jottinger/alcyone/README.md

alcyone
=======

Alcyone is my midi foot controller project.
