jottinger/alcyone/(list of files, drawings)

Other design files:
schematic.fzz
