jottinger/alcyone/wiringPiStub/wiringPi.c

/*
 * wiringPi:
 *	Arduino compatable (ish) Wiring library for the Raspberry Pi
 *	Copyright (c) 2012 Gordon Henderson
 *	Additional code for pwmSetClock by Chris Hall <chris@kchall.plus.com>
 *
 *	Thanks to code samples from Gert Jan van Loo and the
 *	BCM2835 ARM Peripherals manual, however it's missing
 *	the clock section /grr/mutter/
 ***********************************************************************
 * This file is part of wiringPi:
 *	https://projects.drogon.net/raspberry-pi/wiringpi/
 *
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
 *    You should have received a copy of the GNU Lesser General Public
 *    License along with wiringPi.
 *    If not, see <http://www.gnu.org/licenses/>.
 ***********************************************************************
 */

// Revisions:
//	19 Jul 2012:
//		Moved to the LGPL
//		Added an abstraction layer to the main routines to save a tiny
//		bit of run-time and make the clode a little cleaner (if a little
//		larger)
//		Added waitForInterrupt code
//		Added piHiPri code
//
//	 9 Jul 2012:
//		Added in support to use the /sys/class/gpio interface.
//	 2 Jul 2012:
//		Fixed a few more bugs to do with range-checking when in GPIO mode.
//	11 Jun 2012:
//		Fixed some typos.
//		Added c++ support for the .h file
//		Added a new function to allow for using my "pin" numbers, or native
//			GPIO pin numbers.
//		Removed my busy-loop delay and replaced it with a call to delayMicroseconds
//
//	02 May 2012:
//		Added in the 2 UART pins
//		Change maxPins to numPins to more accurately reflect purpose


#include <stdio.h>
#include <stdarg.h>
#include <stdint.h>
#include <stdlib.h>
#include <ctype.h>
#include <poll.h>
#include <unistd.h>
#include <errno.h>
#include <string.h>
#include <time.h>
#include <fcntl.h>
#include <pthread.h>
#include <sys/time.h>
#include <sys/mman.h>
#include <sys/stat.h>
#include <sys/wait.h>
#include <sys/ioctl.h>

#include "wiringPi.h"

#ifndef	TRUE
#define	TRUE	(1==1)
#define	FALSE	(1==2)
#endif

// Environment Variables

#define	ENV_DEBUG	"WIRINGPI_DEBUG"
#define	ENV_CODES	"WIRINGPI_CODES"


// Mask for the bottom 64 pins which belong to the Raspberry Pi
//	The others are available for the other devices

#define	PI_GPIO_MASK	(0xFFFFFFC0)

struct wiringPiNodeStruct *wiringPiNodes = NULL ;

// BCM Magic

#define	BCM_PASSWORD		0x5A000000


// The BCM2835 has 54 GPIO pins.
//	BCM2835 data sheet, Page 90 onwards.
//	There are 6 control registers, each control the functions of a block
//	of 10 pins.
//	Each control register has 10 sets of 3 bits per GPIO pin - the ALT values
//
//	000 = GPIO Pin X is an input
//	001 = GPIO Pin X is an output
//	100 = GPIO Pin X takes alternate function 0
//	101 = GPIO Pin X takes alternate function 1
//	110 = GPIO Pin X takes alternate function 2
//	111 = GPIO Pin X takes alternate function 3
//	011 = GPIO Pin X takes alternate function 4
//	010 = GPIO Pin X takes alternate function 5
//
// So the 3 bits for port X are:
//	X / 10 + ((X % 10) * 3)

// Port function select bits

#define	FSEL_INPT		0b000
#define	FSEL_OUTP		0b001
#define	FSEL_ALT0		0b100
#define	FSEL_ALT1		0b101
#define	FSEL_ALT2		0b110
#define	FSEL_ALT3		0b111
#define	FSEL_ALT4		0b011
#define	FSEL_ALT5		0b010

// Access from ARM Running Linux
//	Taken from Gert/Doms code. Some of this is not in the manual
//	that I can find )-:

#define BCM2708_PERI_BASE	                     0x20000000
#define GPIO_PADS		(BCM2708_PERI_BASE + 0x00100000)
#define CLOCK_BASE		(BCM2708_PERI_BASE + 0x00101000)
#define GPIO_BASE		(BCM2708_PERI_BASE + 0x00200000)
#define GPIO_TIMER		(BCM2708_PERI_BASE + 0x0000B000)
#define GPIO_PWM		(BCM2708_PERI_BASE + 0x0020C000)

#define	PAGE_SIZE		(4*1024)
#define	BLOCK_SIZE		(4*1024)

// PWM
//	Word offsets into the PWM control region

#define	PWM_CONTROL 0
#define	PWM_STATUS  1
#define	PWM0_RANGE  4
#define	PWM0_DATA   5
#define	PWM1_RANGE  8
#define	PWM1_DATA   9

//	Clock regsiter offsets

#define	PWMCLK_CNTL	40
#define	PWMCLK_DIV	41

#define	PWM0_MS_MODE    0x0080  // Run in MS mode
#define	PWM0_USEFIFO    0x0020  // Data from FIFO
#define	PWM0_REVPOLAR   0x0010  // Reverse polarity
#define	PWM0_OFFSTATE   0x0008  // Ouput Off state
#define	PWM0_REPEATFF   0x0004  // Repeat last value if FIFO empty
#define	PWM0_SERIAL     0x0002  // Run in serial mode
#define	PWM0_ENABLE     0x0001  // Channel Enable

#define	PWM1_MS_MODE    0x8000  // Run in MS mode
#define	PWM1_USEFIFO    0x2000  // Data from FIFO
#define	PWM1_REVPOLAR   0x1000  // Reverse polarity
#define	PWM1_OFFSTATE   0x0800  // Ouput Off state
#define	PWM1_REPEATFF   0x0400  // Repeat last value if FIFO empty
#define	PWM1_SERIAL     0x0200  // Run in serial mode
#define	PWM1_ENABLE     0x0100  // Channel Enable

// Timer
//	Word offsets

#define	TIMER_LOAD	(0x400 >> 2)
#define	TIMER_VALUE	(0x404 >> 2)
#define	TIMER_CONTROL	(0x408 >> 2)
#define	TIMER_IRQ_CLR	(0x40C >> 2)
#define	TIMER_IRQ_RAW	(0x410 >> 2)
#define	TIMER_IRQ_MASK	(0x414 >> 2)
#define	TIMER_RELOAD	(0x418 >> 2)
#define	TIMER_PRE_DIV	(0x41C >> 2)
#define	TIMER_COUNTER	(0x420 >> 2)

// Locals to hold pointers to the hardware

static volatile uint32_t *gpio ;
static volatile uint32_t *pwm ;
static volatile uint32_t *clk ;
static volatile uint32_t *pads ;

#ifdef	USE_TIMER
static volatile uint32_t *timer ;
static volatile uint32_t *timerIrqRaw ;
#endif

// Time for easy calculations

static uint64_t epochMilli, epochMicro ;

// Misc

static int wiringPiMode = WPI_MODE_UNINITIALISED ;
static volatile int    pinPass = -1 ;
static pthread_mutex_t pinMutex ;

// Debugging & Return codes

int wiringPiDebug       = FALSE ;
int wiringPiReturnCodes = FALSE ;

// sysFds:
//	Map a file descriptor from the /sys/class/gpio/gpioX/value

static int sysFds [64] =
{
  -1, -1, -1, -1, -1, -1, -1, -1, -1, -1, -1, -1, -1, -1, -1, -1,
  -1, -1, -1, -1, -1, -1, -1, -1, -1, -1, -1, -1, -1, -1, -1, -1,
  -1, -1, -1, -1, -1, -1, -1, -1, -1, -1, -1, -1, -1, -1, -1, -1,
  -1, -1, -1, -1, -1, -1, -1, -1, -1, -1, -1, -1, -1, -1, -1, -1,
} ;

// ISR Data

static void (*isrFunctions [64])(void) ;


// Doing it the Arduino way with lookup tables...
//	Yes, it's probably more innefficient than all the bit-twidling, but it
//	does tend to make it all a bit clearer. At least to me!

// pinToGpio:
//	Take a Wiring pin (0 through X) and re-map it to the BCM_GPIO pin
//	Cope for 2 different board revisions here.

static int *pinToGpio ;

static int pinToGpioR1 [64] =
{
  17, 18, 21, 22, 23, 24, 25, 4,	// From the Original Wiki - GPIO 0 through 7:	wpi  0 -  7
   0,  1,				// I2C  - SDA0, SCL0				wpi  8 -  9
   8,  7,				// SPI  - CE1, CE0				wpi 10 - 11
  10,  9, 11, 				// SPI  - MOSI, MISO, SCLK			wpi 12 - 14
  14, 15,				// UART - Tx, Rx				wpi 15 - 16

// Padding:

      -1, -1, -1, -1, -1, -1, -1, -1, -1, -1, -1, -1, -1, -1, -1,	// ... 31
  -1, -1, -1, -1, -1, -1, -1, -1, -1, -1, -1, -1, -1, -1, -1, -1,	// ... 47
  -1, -1, -1, -1, -1, -1, -1, -1, -1, -1, -1, -1, -1, -1, -1, -1,	// ... 63
} ;

static int pinToGpioR2 [64] =
{
  17, 18, 27, 22, 23, 24, 25, 4,	// From the Original Wiki - GPIO 0 through 7:	wpi  0 -  7
   2,  3,				// I2C  - SDA0, SCL0				wpi  8 -  9
   8,  7,				// SPI  - CE1, CE0				wpi 10 - 11
  10,  9, 11, 				// SPI  - MOSI, MISO, SCLK			wpi 12 - 14
  14, 15,				// UART - Tx, Rx				wpi 15 - 16
  28, 29, 30, 31,			// New GPIOs 8 though 11			wpi 17 - 20

// Padding:

                      -1, -1, -1, -1, -1, -1, -1, -1, -1, -1, -1,	// ... 31
  -1, -1, -1, -1, -1, -1, -1, -1, -1, -1, -1, -1, -1, -1, -1, -1,	// ... 47
  -1, -1, -1, -1, -1, -1, -1, -1, -1, -1, -1, -1, -1, -1, -1, -1,	// ... 63
} ;


// physToGpio:
//	Take a physical pin (1 through 26) and re-map it to the BCM_GPIO pin
//	Cope for 2 different board revisions here.

static int *physToGpio ;

static int physToGpioR1 [64] =
{
  -1,		// 0
  -1, -1,	// 1, 2
   0, -1,
   1, -1,
   4, 14,
  -1, 15,
  17, 18,
  21, -1,
  22, 23,
  -1, 24,
  10, -1,
   9, 25,
  11,  8,
  -1,  7,	// 25, 26

// Padding:

                                              -1, -1, -1, -1, -1,	// ... 31
  -1, -1, -1, -1, -1, -1, -1, -1, -1, -1, -1, -1, -1, -1, -1, -1,	// ... 47
  -1, -1, -1, -1, -1, -1, -1, -1, -1, -1, -1, -1, -1, -1, -1, -1,	// ... 63
} ;

static int physToGpioR2 [64] =
{
  -1,		// 0
  -1, -1,	// 1, 2
   2, -1,
   3, -1,
   4, 14,
  -1, 15,
  17, 18,
  27, -1,
  22, 23,
  -1, 24,
  10, -1,
   9, 25,
  11,  8,
  -1,  7,	// 25, 26

// Padding:

                                              -1, -1, -1, -1, -1,	// ... 31
  -1, -1, -1, -1, -1, -1, -1, -1, -1, -1, -1, -1, -1, -1, -1, -1,	// ... 47
  -1, -1, -1, -1, -1, -1, -1, -1, -1, -1, -1, -1, -1, -1, -1, -1,	// ... 63
} ;


// gpioToGPFSEL:
//	Map a BCM_GPIO pin to it's Function Selection
//	control port. (GPFSEL 0-5)
//	Groups of 10 - 3 bits per Function - 30 bits per port

static uint8_t gpioToGPFSEL [] =
{
  0,0,0,0,0,0,0,0,0,0,
  1,1,1,1,1,1,1,1,1,1,
  2,2,2,2,2,2,2,2,2,2,
  3,3,3,3,3,3,3,3,3,3,
  4,4,4,4,4,4,4,4,4,4,
  5,5,5,5,5,5,5,5,5,5,
} ;


// gpioToShift
//	Define the shift up for the 3 bits per pin in each GPFSEL port

static uint8_t gpioToShift [] =
{
  0,3,6,9,12,15,18,21,24,27,
  0,3,6,9,12,15,18,21,24,27,
  0,3,6,9,12,15,18,21,24,27,
  0,3,6,9,12,15,18,21,24,27,
  0,3,6,9,12,15,18,21,24,27,
} ;


// gpioToGPSET:
//	(Word) offset to the GPIO Set registers for each GPIO pin

static uint8_t gpioToGPSET [] =
{
   7, 7, 7, 7, 7, 7, 7, 7, 7, 7, 7, 7, 7, 7, 7, 7, 7, 7, 7, 7, 7, 7, 7, 7, 7, 7, 7, 7, 7, 7, 7, 7,
   8, 8, 8, 8, 8, 8, 8, 8, 8, 8, 8, 8, 8, 8, 8, 8, 8, 8, 8, 8, 8, 8, 8, 8, 8, 8, 8, 8, 8, 8, 8, 8,
} ;

// gpioToGPCLR:
//	(Word) offset to the GPIO Clear registers for each GPIO pin

static uint8_t gpioToGPCLR [] =
{
  10,10,10,10,10,10,10,10,10,10,10,10,10,10,10,10,10,10,10,10,10,10,10,10,10,10,10,10,10,10,10,10,
  11,11,11,11,11,11,11,11,11,11,11,11,11,11,11,11,11,11,11,11,11,11,11,11,11,11,11,11,11,11,11,11,
} ;


// gpioToGPLEV:
//	(Word) offset to the GPIO Input level registers for each GPIO pin

static uint8_t gpioToGPLEV [] =
{
  13,13,13,13,13,13,13,13,13,13,13,13,13,13,13,13,13,13,13,13,13,13,13,13,13,13,13,13,13,13,13,13,
  14,14,14,14,14,14,14,14,14,14,14,14,14,14,14,14,14,14,14,14,14,14,14,14,14,14,14,14,14,14,14,14,
} ;


#ifdef notYetReady
// gpioToEDS
//	(Word) offset to the Event Detect Status

static uint8_t gpioToEDS [] =
{
  16,16,16,16,16,16,16,16,16,16,16,16,16,16,16,16,16,16,16,16,16,16,16,16,16,16,16,16,16,16,16,16,
  17,17,17,17,17,17,17,17,17,17,17,17,17,17,17,17,17,17,17,17,17,17,17,17,17,17,17,17,17,17,17,17,
} ;

// gpioToREN
//	(Word) offset to the Rising edgde ENable register

static uint8_t gpioToREN [] =
{
  19,19,19,19,19,19,19,19,19,19,19,19,19,19,19,19,19,19,19,19,19,19,19,19,19,19,19,19,19,19,19,19,
  20,20,20,20,20,20,20,20,20,20,20,20,20,20,20,20,20,20,20,20,20,20,20,20,20,20,20,20,20,20,20,20,
} ;

// gpioToFEN
//	(Word) offset to the Falling edgde ENable register

static uint8_t gpioToFEN [] =
{
  22,22,22,22,22,22,22,22,22,22,22,22,22,22,22,22,22,22,22,22,22,22,22,22,22,22,22,22,22,22,22,22,
  23,23,23,23,23,23,23,23,23,23,23,23,23,23,23,23,23,23,23,23,23,23,23,23,23,23,23,23,23,23,23,23,
} ;
#endif


// GPPUD:
//	GPIO Pin pull up/down register

#define	GPPUD	37

// gpioToPUDCLK
//	(Word) offset to the Pull Up Down Clock regsiter

static uint8_t gpioToPUDCLK [] =
{
  38,38,38,38,38,38,38,38,38,38,38,38,38,38,38,38,38,38,38,38,38,38,38,38,38,38,38,38,38,38,38,38,
  39,39,39,39,39,39,39,39,39,39,39,39,39,39,39,39,39,39,39,39,39,39,39,39,39,39,39,39,39,39,39,39,
} ;


// gpioToPwmALT
//	the ALT value to put a GPIO pin into PWM mode

static uint8_t gpioToPwmALT [] =
{
          0,         0,         0,         0,         0,         0,         0,         0,	//  0 ->  7
          0,         0,         0,         0, FSEL_ALT0, FSEL_ALT0,         0,         0, 	//  8 -> 15
          0,         0, FSEL_ALT5, FSEL_ALT5,         0,         0,         0,         0, 	// 16 -> 23
          0,         0,         0,         0,         0,         0,         0,         0,	// 24 -> 31
          0,         0,         0,         0,         0,         0,         0,         0,	// 32 -> 39
  FSEL_ALT0, FSEL_ALT0,         0,         0,         0, FSEL_ALT0,         0,         0,	// 40 -> 47
          0,         0,         0,         0,         0,         0,         0,         0,	// 48 -> 55
          0,         0,         0,         0,         0,         0,         0,         0,	// 56 -> 63
} ;


// gpioToPwmPort
//	The port value to put a GPIO pin into PWM mode

static uint8_t gpioToPwmPort [] =
{
          0,         0,         0,         0,         0,         0,         0,         0,	//  0 ->  7
          0,         0,         0,         0, PWM0_DATA, PWM1_DATA,         0,         0, 	//  8 -> 15
          0,         0, PWM0_DATA, PWM1_DATA,         0,         0,         0,         0, 	// 16 -> 23
          0,         0,         0,         0,         0,         0,         0,         0,	// 24 -> 31
          0,         0,         0,         0,         0,         0,         0,         0,	// 32 -> 39
  PWM0_DATA, PWM1_DATA,         0,         0,         0, PWM1_DATA,         0,         0,	// 40 -> 47
          0,         0,         0,         0,         0,         0,         0,         0,	// 48 -> 55
          0,         0,         0,         0,         0,         0,         0,         0,	// 56 -> 63

} ;

// gpioToGpClkALT:
//	ALT value to put a GPIO pin into GP Clock mode.
//	On the Pi we can really only use BCM_GPIO_4 and BCM_GPIO_21
//	for clocks 0 and 1 respectively, however I'll include the full
//	list for completeness - maybe one day...

#define	GPIO_CLOCK_SOURCE	1

// gpioToGpClkALT0:

static uint8_t gpioToGpClkALT0 [] =
{
          0,         0,         0,         0, FSEL_ALT0, FSEL_ALT0, FSEL_ALT0,         0,	//  0 ->  7
          0,         0,         0,         0,         0,         0,         0,         0, 	//  8 -> 15
          0,         0,         0,         0, FSEL_ALT5, FSEL_ALT5,         0,         0, 	// 16 -> 23
          0,         0,         0,         0,         0,         0,         0,         0,	// 24 -> 31
  FSEL_ALT0,         0, FSEL_ALT0,         0,         0,         0,         0,         0,	// 32 -> 39
          0,         0, FSEL_ALT0, FSEL_ALT0, FSEL_ALT0,         0,         0,         0,	// 40 -> 47
          0,         0,         0,         0,         0,         0,         0,         0,	// 48 -> 55
          0,         0,         0,         0,         0,         0,         0,         0,	// 56 -> 63
} ;

// gpioToClk:
//	(word) Offsets to the clock Control and Divisor register

static uint8_t gpioToClkCon [] =
{
         -1,        -1,        -1,        -1,        28,        30,        32,        -1,	//  0 ->  7
         -1,        -1,        -1,        -1,        -1,        -1,        -1,        -1, 	//  8 -> 15
         -1,        -1,        -1,        -1,        28,        30,        -1,        -1, 	// 16 -> 23
         -1,        -1,        -1,        -1,        -1,        -1,        -1,        -1,	// 24 -> 31
         28,        -1,        28,        -1,        -1,        -1,        -1,        -1,	// 32 -> 39
         -1,        -1,        28,        30,        28,        -1,        -1,        -1,	// 40 -> 47
         -1,        -1,        -1,        -1,        -1,        -1,        -1,        -1,	// 48 -> 55
         -1,        -1,        -1,        -1,        -1,        -1,        -1,        -1,	// 56 -> 63
} ;

static uint8_t gpioToClkDiv [] =
{
         -1,        -1,        -1,        -1,        29,        31,        33,        -1,	//  0 ->  7
         -1,        -1,        -1,        -1,        -1,        -1,        -1,        -1, 	//  8 -> 15
         -1,        -1,        -1,        -1,        29,        31,        -1,        -1, 	// 16 -> 23
         -1,        -1,        -1,        -1,        -1,        -1,        -1,        -1,	// 24 -> 31
         29,        -1,        29,        -1,        -1,        -1,        -1,        -1,	// 32 -> 39
         -1,        -1,        29,        31,        29,        -1,        -1,        -1,	// 40 -> 47
         -1,        -1,        -1,        -1,        -1,        -1,        -1,        -1,	// 48 -> 55
         -1,        -1,        -1,        -1,        -1,        -1,        -1,        -1,	// 56 -> 63
} ;


/*
 * Functions
 *********************************************************************************
 */


/*
 * wiringPiFailure:
 *	Fail. Or not.
 *********************************************************************************
 */

int wiringPiFailure (int fatal, const char *message, ...)
{
  va_list argp ;
  char buffer [1024] ;

  if (!fatal && wiringPiReturnCodes)
    return -1 ;

  va_start (argp, message) ;
    vsnprintf (buffer, 1023, message, argp) ;
  va_end (argp) ;

  fprintf (stderr, "%s", buffer) ;
  exit (EXIT_FAILURE) ;

  return 0 ;
}


/*
 * piBoardRev:
 *	Return a number representing the hardware revision of the board.
 *	Revision is currently 1 or 2.
 *
 *	Much confusion here )-:
 *	Seems there are some boards with 0000 in them (mistake in manufacture)
 *	and some board with 0005 in them (another mistake in manufacture?)
 *	So the distinction between boards that I can see is:
 *	0000 - Error
 *	0001 - Not used
 *	0002 - Rev 1
 *	0003 - Rev 1
 *	0004 - Rev 2 (Early reports?
 *	0005 - Rev 2 (but error?)
 *	0006 - Rev 2
 *	0008 - Rev 2 - Model A
 *	000e - Rev 2 + 512MB
 *	000f - Rev 2 + 512MB
 *
 *	A small thorn is the olde style overvolting - that will add in
 *		1000000
 *
 *********************************************************************************
 */

int piBoardRev (void)
{
    return 2;
}


/*
 * wpiPinToGpio:
 *	Translate a wiringPi Pin number to native GPIO pin number.
 *	Provided for external support.
 *********************************************************************************
 */

int wpiPinToGpio (int wpiPin)
{
  return pinToGpio [wpiPin & 63] ;
}


/*
 * physPinToGpio:
 *	Translate a physical Pin number to native GPIO pin number.
 *	Provided for external support.
 *********************************************************************************
 */

int physPinToGpio (int physPin)
{
  return physToGpio [physPin & 63] ;
}


/*
 * setPadDrive:
 *	Set the PAD driver value
 *********************************************************************************
 */

void setPadDrive (int group, int value)
{
}


/*
 * getAlt:
 *	Returns the ALT bits for a given port. Only really of-use
 *	for the gpio readall command (I think)
 *********************************************************************************
 */

int getAlt (int pin)
{
  return 0;
}


/*
 * pwmSetMode:
 *	Select the native "balanced" mode, or standard mark:space mode
 *********************************************************************************
 */

void pwmSetMode (int mode)
{
}


/*
 * pwmSetRange:
 *	Set the PWM range register. We set both range registers to the same
 *	value. If you want different in your own code, then write your own.
 *********************************************************************************
 */

void pwmSetRange (unsigned int range)
{
}


/*
 * pwmSetClock:
 *	Set/Change the PWM clock. Originally my code, but changed
 *	(for the better!) by Chris Hall, <chris@kchall.plus.com>
 *	after further study of the manual and testing with a 'scope
 *********************************************************************************
 */

void pwmSetClock (int divisor)
{
}


/*
 * gpioClockSet:
 *	Set the freuency on a GPIO clock pin
 *********************************************************************************
 */

void gpioClockSet (int pin, int freq)
{
}


/*
 * wiringPiFindNode:
 *      Locate our device node
 *********************************************************************************
 */

struct wiringPiNodeStruct *wiringPiFindNode (int pin)
{
  return NULL ;
}


/*
 * wiringPiNewNode:
 *	Create a new GPIO node into the wiringPi handling system
 *********************************************************************************
 */

static void pinModeDummy             (struct wiringPiNodeStruct *node, int pin, int mode)  { return ; }
static void pullUpDnControlDummy     (struct wiringPiNodeStruct *node, int pin, int pud)   { return ; }
static int  digitalReadDummy         (struct wiringPiNodeStruct *node, int pin)            { return LOW ; }
static void digitalWriteDummy        (struct wiringPiNodeStruct *node, int pin, int value) { return ; }
static void pwmWriteDummy            (struct wiringPiNodeStruct *node, int pin, int value) { return ; }
static int  analogReadDummy          (struct wiringPiNodeStruct *node, int pin)            { return 0 ; }
static void analogWriteDummy         (struct wiringPiNodeStruct *node, int pin, int value) { return ; }

struct wiringPiNodeStruct *wiringPiNewNode (int pinBase, int numPins)
{
  return NULL ;
}


#ifdef notYetReady
/*
 * pinED01:
 * pinED10:
 *	Enables edge-detect mode on a pin - from a 0 to a 1 or 1 to 0
 *	Pin must already be in input mode with appropriate pull up/downs set.
 *********************************************************************************
 */

void pinEnableED01Pi (int pin)
{
  pin = pinToGpio [pin & 63] ;
}
#endif


/*
 *********************************************************************************
 * Core Functions
 *********************************************************************************
 */

/*
 * pinModeAlt:
 *	This is an un-documented special to let you set any pin to any mode
 *********************************************************************************
 */

void pinModeAlt (int pin, int mode)
{
}


/*
 * pinMode:
 *	Sets the mode of a pin to be input, output or PWM output
 *********************************************************************************
 */

void pinMode (int pin, int mode)
{
}


/*
 * pullUpDownCtrl:
 *	Control the internal pull-up/down resistors on a GPIO pin
 *	The Arduino only has pull-ups and these are enabled by writing 1
 *	to a port when in input mode - this paradigm doesn't quite apply
 *	here though.
 *********************************************************************************
 */

void pullUpDnControl (int pin, int pud)
{
}


/*
 * digitalRead:
 *	Read the value of a given Pin, returning HIGH or LOW
 *********************************************************************************
 */

int digitalRead (int pin)
{
return LOW;
}


/*
 * digitalWrite:
 *	Set an output bit
 *********************************************************************************
 */

void digitalWrite (int pin, int value)
{
}


/*
 * pwmWrite:
 *	Set an output PWM value
 *********************************************************************************
 */

void pwmWrite (int pin, int value)
{
}


/*
 * analogRead:
 *	Read the analog value of a given Pin.
 *	There is no on-board Pi analog hardware,
 *	so this needs to go to a new node.
 *********************************************************************************
 */

int analogRead (int pin)
{
}


/*
 * analogWrite:
 *	Write the analog value to the given Pin.
 *	There is no on-board Pi analog hardware,
 *	so this needs to go to a new node.
 *********************************************************************************
 */

void analogWrite (int pin, int value)
{
}



/*
 * digitalWriteByte:
 *	Pi Specific
 *	Write an 8-bit byte to the first 8 GPIO pins - try to do it as
 *	fast as possible.
 *	However it still needs 2 operations to set the bits, so any external
 *	hardware must not rely on seeing a change as there will be a change
 *	to set the outputs bits to zero, then another change to set the 1's
 *********************************************************************************
 */

void digitalWriteByte (int value)
{
}


/*
 * waitForInterrupt:
 *	Pi Specific.
 *	Wait for Interrupt on a GPIO pin.
 *	This is actually done via the /sys/class/gpio interface regardless of
 *	the wiringPi access mode in-use. Maybe sometime it might get a better
 *	way for a bit more efficiency.
 *********************************************************************************
 */

int waitForInterrupt (int pin, int mS)
{
return 0;
}


/*
 * interruptHandler:
 *	This is a thread and gets started to wait for the interrupt we're
 *	hoping to catch. It will call the user-function when the interrupt
 *	fires.
 *********************************************************************************
 */

static void *interruptHandler (void *arg)
{
  return NULL ;
}


/*
 * wiringPiISR:
 *	Pi Specific.
 *	Take the details and create an interrupt handler that will do a call-
 *	back to the user supplied function.
 *********************************************************************************
 */

int wiringPiISR (int pin, int mode, void (*function)(void))
{
  return 0 ;
}


/*
 * initialiseEpoch:
 *	Initialise our start-of-time variable to be the current unix
 *	time in milliseconds and microseconds.
 *********************************************************************************
 */

static void initialiseEpoch (void)
{
  struct timeval tv ;

  gettimeofday (&tv, NULL) ;
  epochMilli = (uint64_t)tv.tv_sec * (uint64_t)1000    + (uint64_t)(tv.tv_usec / 1000) ;
  epochMicro = (uint64_t)tv.tv_sec * (uint64_t)1000000 + (uint64_t)(tv.tv_usec) ;
}


/*
 * delay:
 *	Wait for some number of milliseconds
 *********************************************************************************
 */

void delay (unsigned int howLong)
{
  struct timespec sleeper, dummy ;

  sleeper.tv_sec  = (time_t)(howLong / 1000) ;
  sleeper.tv_nsec = (long)(howLong % 1000) * 1000000 ;

  nanosleep (&sleeper, &dummy) ;
}


/*
 * delayMicroseconds:
 *	This is somewhat intersting. It seems that on the Pi, a single call
 *	to nanosleep takes some 80 to 130 microseconds anyway, so while
 *	obeying the standards (may take longer), it's not always what we
 *	want!
 *
 *	So what I'll do now is if the delay is less than 100uS we'll do it
 *	in a hard loop, watching a built-in counter on the ARM chip. This is
 *	somewhat sub-optimal in that it uses 100% CPU, something not an issue
 *	in a microcontroller, but under a multi-tasking, multi-user OS, it's
 *	wastefull, however we've no real choice )-:
 *
 *      Plan B: It seems all might not be well with that plan, so changing it
 *      to use gettimeofday () and poll on that instead...
 *********************************************************************************
 */

void delayMicrosecondsHard (unsigned int howLong)
{
  struct timeval tNow, tLong, tEnd ;

  gettimeofday (&tNow, NULL) ;
  tLong.tv_sec  = howLong / 1000000 ;
  tLong.tv_usec = howLong % 1000000 ;
  timeradd (&tNow, &tLong, &tEnd) ;

  while (timercmp (&tNow, &tEnd, <))
    gettimeofday (&tNow, NULL) ;
}

void delayMicroseconds (unsigned int howLong)
{
  struct timespec sleeper ;
  unsigned int uSecs = howLong % 1000000 ;
  unsigned int wSecs = howLong / 1000000 ;

  /**/ if (howLong ==   0)
    return ;
  else if (howLong  < 100)
    delayMicrosecondsHard (howLong) ;
  else
  {
    sleeper.tv_sec  = wSecs ;
    sleeper.tv_nsec = (long)(uSecs * 1000L) ;
    nanosleep (&sleeper, NULL) ;
  }
}


/*
 * millis:
 *	Return a number of milliseconds as an unsigned int.
 *********************************************************************************
 */

unsigned int millis (void)
{
  struct timeval tv ;
  uint64_t now ;

  gettimeofday (&tv, NULL) ;
  now  = (uint64_t)tv.tv_sec * (uint64_t)1000 + (uint64_t)(tv.tv_usec / 1000) ;

  return (uint32_t)(now - epochMilli) ;
}


/*
 * micros:
 *	Return a number of microseconds as an unsigned int.
 *********************************************************************************
 */

unsigned int micros (void)
{
  struct timeval tv ;
  uint64_t now ;

  gettimeofday (&tv, NULL) ;
  now  = (uint64_t)tv.tv_sec * (uint64_t)1000000 + (uint64_t)tv.tv_usec ;

  return (uint32_t)(now - epochMicro) ;
}


/*
 * wiringPiSetup:
 *	Must be called once at the start of your program execution.
 *
 * Default setup: Initialises the system into wiringPi Pin mode and uses the
 *	memory mapped hardware directly.
 *********************************************************************************
 */

int wiringPiSetup (void)
{

#ifdef	USE_TIMER
// The system timer

  timer = (uint32_t *)mmap(0, BLOCK_SIZE, PROT_READ|PROT_WRITE, MAP_SHARED, fd, GPIO_TIMER) ;
  if ((int32_t)timer == -1)
    return wiringPiFailure (WPI_ALMOST, "wiringPiSetup: mmap (TIMER) failed: %s\n", strerror (errno)) ;

// Set the timer to free-running, 1MHz.
//	0xF9 is 249, the timer divide is base clock / (divide+1)
//	so base clock is 250MHz / 250 = 1MHz.

  *(timer + TIMER_CONTROL) = 0x0000280 ;
  *(timer + TIMER_PRE_DIV) = 0x00000F9 ;
  timerIrqRaw = timer + TIMER_IRQ_RAW ;
#endif

  initialiseEpoch () ;

  return 0 ;
}


/*
 * wiringPiSetupGpio:
 *	Must be called once at the start of your program execution.
 *
 * GPIO setup: Initialises the system into GPIO Pin mode and uses the
 *	memory mapped hardware directly.
 *********************************************************************************
 */

int wiringPiSetupGpio (void)
{
  return 0 ;
}


/*
 * wiringPiSetupPhys:
 *	Must be called once at the start of your program execution.
 *
 * Phys setup: Initialises the system into Physical Pin mode and uses the
 *	memory mapped hardware directly.
 *********************************************************************************
 */

int wiringPiSetupPhys (void)
{
  return 0 ;
}


/*
 * wiringPiSetupSys:
 *	Must be called once at the start of your program execution.
 *
 * Initialisation (again), however this time we are using the /sys/class/gpio
 *	interface to the GPIO systems - slightly slower, but always usable as
 *	a non-root user, assuming the devices are already exported and setup correctly.
 */

int wiringPiSetupSys (void)
{
  return 0 ;
}
