jottinger/alcyone/wiringPiStub/wiringPiI2C.c

/*
 * wiringPiI2C.c:
 *	Simplified I2C access routines
 *	Copyright (c) 2013 Gordon Henderson
 ***********************************************************************
 * This file is part of wiringPi:
 *	https://projects.drogon.net/raspberry-pi/wiringpi/
 *
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
 *    You should have received a copy of the GNU Lesser General Public
 *    License along with wiringPi.
 *    If not, see <http://www.gnu.org/licenses/>.
 ***********************************************************************
 */

/*
 * Notes:
 *	The Linux I2C code is actually the same (almost) as the SMBus code.
 *	SMBus is System Management Bus - and in essentially I2C with some
 *	additional functionality added, and stricter controls on the electrical
 *	specifications, etc. however I2C does work well with it and the
 *	protocols work over both.
 *
 *	I'm directly including the SMBus functions here as some Linux distros
 *	lack the correct header files, and also some header files are GPLv2
 *	rather than the LGPL that wiringPi is released under - presumably because
 *	originally no-one expected I2C/SMBus to be used outside the kernel -
 *	however enter the Raspberry Pi with people now taking directly to I2C
 *	devices without going via the kernel...
 *
 *	This may ultimately reduce the flexibility of this code, but it won't be
 *	hard to maintain it and keep it current, should things change.
 *
 *	Information here gained from: kernel/Documentation/i2c/dev-interface
 *	as well as other online resources.
 *********************************************************************************
 */

#include <stdio.h>
#include <stdlib.h>
#include <stdint.h>
#include <errno.h>
#include <string.h>
#include <fcntl.h>
#include <sys/ioctl.h>

#include "wiringPi.h"
#include "wiringPiI2C.h"

// I2C definitions

#define I2C_SLAVE	0x0703
#define I2C_SMBUS	0x0720	/* SMBus-level access */

#define I2C_SMBUS_READ	1
#define I2C_SMBUS_WRITE	0

// SMBus transaction types

#define I2C_SMBUS_QUICK		    0
#define I2C_SMBUS_BYTE		    1
#define I2C_SMBUS_BYTE_DATA	    2
#define I2C_SMBUS_WORD_DATA	    3
#define I2C_SMBUS_PROC_CALL	    4
#define I2C_SMBUS_BLOCK_DATA	    5
#define I2C_SMBUS_I2C_BLOCK_BROKEN  6
#define I2C_SMBUS_BLOCK_PROC_CALL   7		/* SMBus 2.0 */
#define I2C_SMBUS_I2C_BLOCK_DATA    8

// SMBus messages

#define I2C_SMBUS_BLOCK_MAX	32	/* As specified in SMBus standard */
#define I2C_SMBUS_I2C_BLOCK_MAX	32	/* Not specified but we use same structure */

// Structures used in the ioctl() calls

union i2c_smbus_data
{
  uint8_t  byte ;
  uint16_t word ;
  uint8_t  block [I2C_SMBUS_BLOCK_MAX + 2] ;	// block [0] is used for length + one more for PEC
} ;

struct i2c_smbus_ioctl_data
{
  char read_write ;
  uint8_t command ;
  int size ;
  union i2c_smbus_data *data ;
} ;

static inline int i2c_smbus_access (int fd, char rw, uint8_t command, int size, union i2c_smbus_data *data)
{
  struct i2c_smbus_ioctl_data args ;

  args.read_write = rw ;
  args.command    = command ;
  args.size       = size ;
  args.data       = data ;
  return ioctl (fd, I2C_SMBUS, &args) ;
}


/*
 * wiringPiI2CRead:
 *	Simple device read
 *********************************************************************************
 */

int wiringPiI2CRead (int fd)
{
    return 0;
}


/*
 * wiringPiI2CReadReg8: wiringPiI2CReadReg16:
 *	Read an 8 or 16-bit value from a regsiter on the device
 *********************************************************************************
 */

int wiringPiI2CReadReg8 (int fd, int reg)
{
return 0;
}

int wiringPiI2CReadReg16 (int fd, int reg)
{
return 0;
}


/*
 * wiringPiI2CWrite:
 *	Simple device write
 *********************************************************************************
 */

int wiringPiI2CWrite (int fd, int data)
{
return 0;
}


/*
 * wiringPiI2CWriteReg8: wiringPiI2CWriteReg16:
 *	Write an 8 or 16-bit value to the given register
 *********************************************************************************
 */

int wiringPiI2CWriteReg8 (int fd, int reg, int value)
{
return 0;
}

int wiringPiI2CWriteReg16 (int fd, int reg, int value)
{
    return 0;
}


/*
 * wiringPiI2CSetupInterface:
 *	Undocumented access to set the interface explicitly - might be used
 *	for the Pi's 2nd I2C interface...
 *********************************************************************************
 */

int wiringPiI2CSetupInterface (const char *device, int devId)
{
  return 0;
}


/*
 * wiringPiI2CSetup:
 *	Open the I2C device, and regsiter the target device
 *********************************************************************************
 */

int wiringPiI2CSetup (const int devId)
{
 return 0;
}
