jottinger/alcyone/wiringPiStub/wiringSerial.c

/*
 * wiringSerial.c:
 *	Handle a serial port
 ***********************************************************************
 * This file is part of wiringPi:
 *	https://projects.drogon.net/raspberry-pi/wiringpi/
 *
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
 *    You should have received a copy of the GNU Lesser General Public License
 *    along with wiringPi.  If not, see <http://www.gnu.org/licenses/>.
 ***********************************************************************
 */

#include <stdio.h>
#include <stdlib.h>
#include <stdint.h>
#include <stdarg.h>
#include <string.h>
#include <termios.h>
#include <unistd.h>
#include <fcntl.h>
#include <sys/ioctl.h>
#include <sys/types.h>
#include <sys/stat.h>

#include "wiringSerial.h"

/*
 * serialOpen:
 *	Open and initialise the serial port, setting all the right
 *	port parameters - or as many as are required - hopefully!
 *********************************************************************************
 */

int serialOpen (const char *device, const int baud)
{
return 0;
}


/*
 * serialFlush:
 *	Flush the serial buffers (both tx & rx)
 *********************************************************************************
 */

void serialFlush (const int fd)
{
}


/*
 * serialClose:
 *	Release the serial port
 *********************************************************************************
 */

void serialClose (const int fd)
{
}


/*
 * serialPutchar:
 *	Send a single character to the serial port
 *********************************************************************************
 */

void serialPutchar (const int fd, const unsigned char c)
{
}


/*
 * serialPuts:
 *	Send a string to the serial port
 *********************************************************************************
 */

void serialPuts (const int fd, const char *s)
{
}

/*
 * serialPrintf:
 *	Printf over Serial
 *********************************************************************************
 */

void serialPrintf (const int fd, const char *message, ...)
{
}


/*
 * serialDataAvail:
 *	Return the number of bytes of data avalable to be read in the serial port
 *********************************************************************************
 */

int serialDataAvail (const int fd)
{
return -1;
}


/*
 * serialGetchar:
 *	Get a single character from the serial device.
 *	Note: Zero is a valid character and this function will time-out after
 *	10 seconds.
 *********************************************************************************
 */

int serialGetchar (const int fd)
{
return 0;
}
