jottinger/alcyone/(commit log)

2013-03-25 Flare works now, esp when LED is hooked up to power
2013-03-26 Adding MIDI channel reset
    [alcyone.cpp]
2013-03-26 Committing project changes, plus inverting notes for the actual pedals
    [alcyone.cpp]
2013-03-29 Changing debounce size to 21 for stability
    [debounce.h]
2013-03-31 first cut of headless alcyone beta
2013-04-01 Conversion to enum for messages in C++, addition of the connection class prototypes in java
2013-04-01 First cut of Java UI - no reset, no transposition or channel support yet
2013-04-03 Putting network communication in its own thread, safely (or trying to)
2013-04-03 flare now in its own thread, adding verbose message decoding
2013-04-04 first cut of webserver aspect
2013-04-17 Tests revealed that I've been coding in Java too long. Forgot to use pointers.
    [alcyone.cpp, alcyoneServer.cpp, debounce.cpp, flare.cpp, mcp23008.cpp, mcp23008.h, midi.cpp, midi.h]
2013-05-10 Initial schematic commit from Fritzing
    [schematic.fzz]
2013-05-10 rotating to be readable, eh
    [schematic.fzz]
2013-06-20 Updating for Pidora, stage 1
2013-06-26 okay, let's fix the note on and note off code, so that we're sending the right notes
    [midi.cpp]
2013-06-26 First cut of the client-neutral control app
2013-08-13 BROKEN BUILD: still working on multiplatform, plus added web++.hpp where it belongs
    [web++.hpp]
