jottinger/alcyone/(notices)

Notices in the files:
wiringPiStub/wiringPi.c:
wiringPi is free software: you can redistribute it and/or modify
it under the terms of the GNU Lesser General Public License as
published by the Free Software Foundation, either version 3 of the
License, or (at your option) any later version.
src/alcyone.cpp:
Alcyone is free software: you can redistribute it and/or modify
it under the terms of the GNU General Public License as published by
the Free Software Foundation, either version 3 of the License, or
(at your option) any later version.
wiringPiStub/wiringSerial.c:
it under the terms of the GNU Lesser General Public License as published by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
